mrqchip/TermWylPompy/Dokument/ZdjeciaOkolicPompy/IMG_20190823_191804.jpg

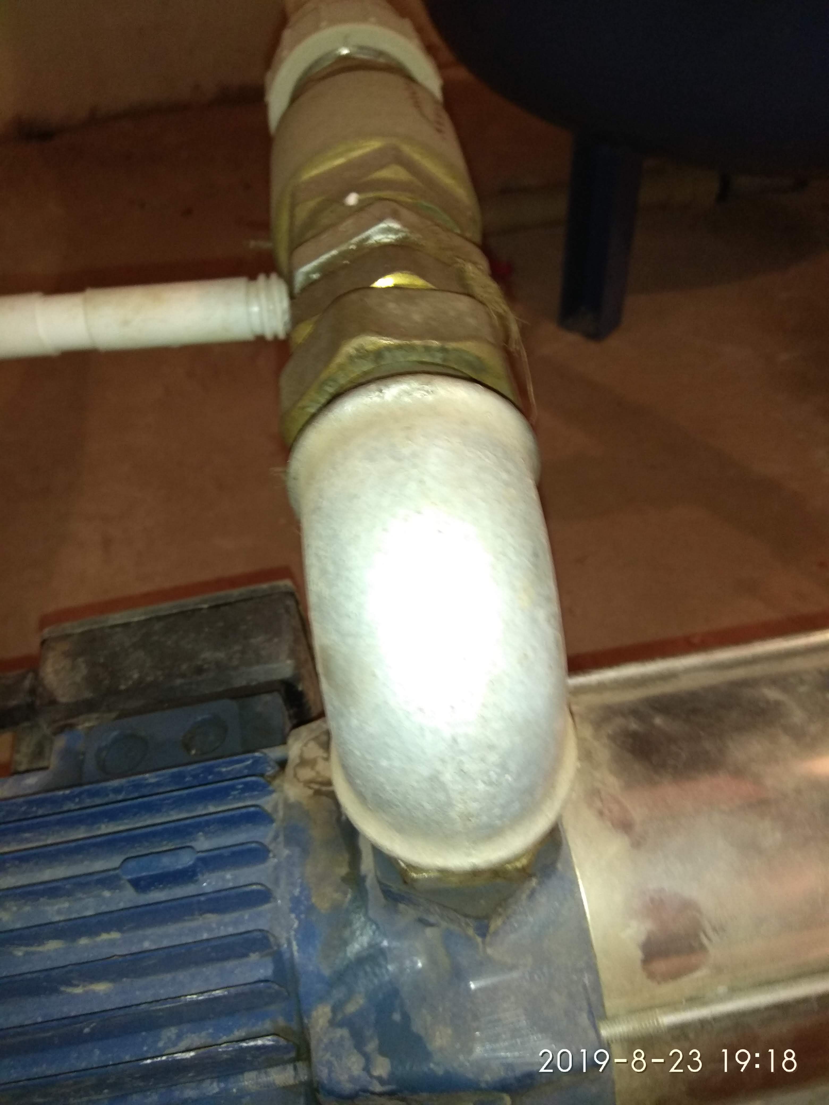
Dokument/ZdjeciaOkolicPompy/IMG_20190823_191804.jpg
