mrqchip/TermWylPompy/TermWylPompy/tflex/TermWylPompyBase.png

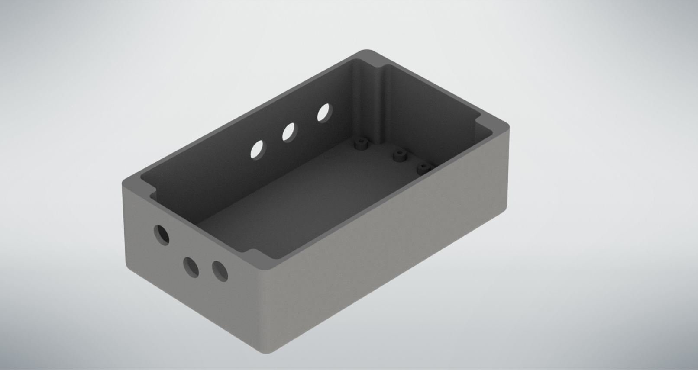
TermWylPompy/tflex/TermWylPompyBase.png
