mrqchip/TermWylPompy/README.md

# TermWylPompy
## Wyłącznik pompy ogrodowej, chroniący ją przed długotrwałym suchobiegiem.

Suchobieg pompy jest wykrywany przez pomiar temperatury korpusu pompy i nadmiernie długi czas włączenia (np. 2 godziny lub 30 stopni ponad temperaturę otoczenia, co pierwsze wystąpi). Badana jest temperatura silnika, temperatura rury na wyjściu z pompy i temperatura otoczenia.
Po stwierdzeniu suchobiegu pompa jest trwale wyłączana i wymaga interwencji personelu, 
który powinien stwierdzić przyczynę braku wody w  instalacji.
Kasowanie stanu suchobiegu włącza pompę na zadany czas. Jeśli w tym czasie nie nastapi obniżenie temperatury poniżej zadanej,
wyłącznik wprowadzi się znowu w stan suchobiegu.
Sterownik co ustalony czas (np. 192 godziny) od ostatniego włączenia pompy otwiera elektrozawór opróżniający instalację. To wymusza włączenie pompy i po jej włączeniu elektrozawór jest zamykany.
