mrqchip/TermWylPompy/Dokument/ZdjeciaOkolicPompy/IMG_20190823_191732.jpg

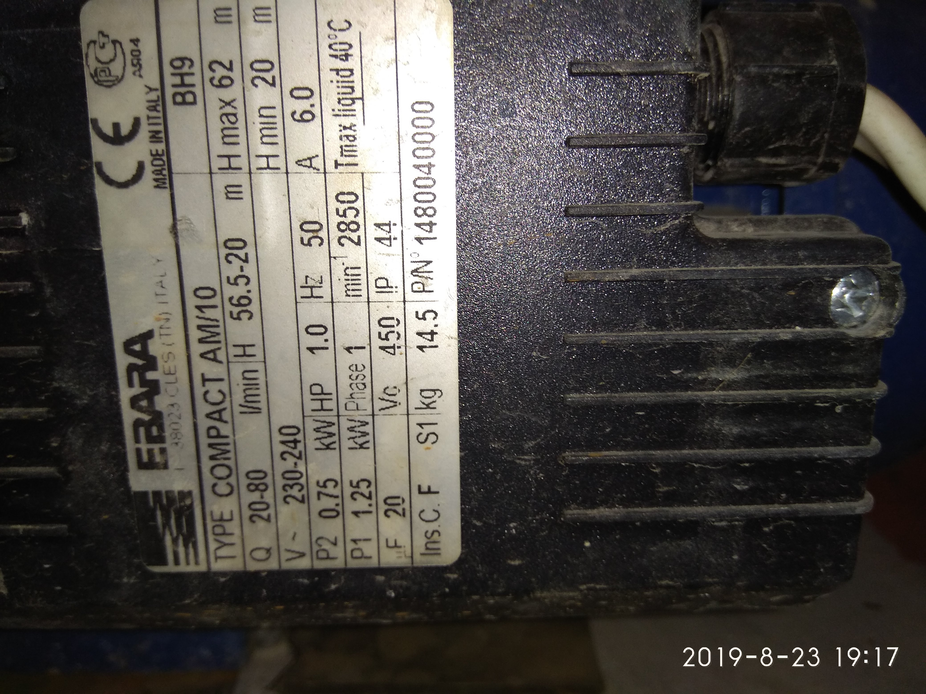
Dokument/ZdjeciaOkolicPompy/IMG_20190823_191732.jpg
