mrqchip/TermWylPompy/Dokument/ZdjeciaOkolicPompy/IMG_20190823_191752.jpg

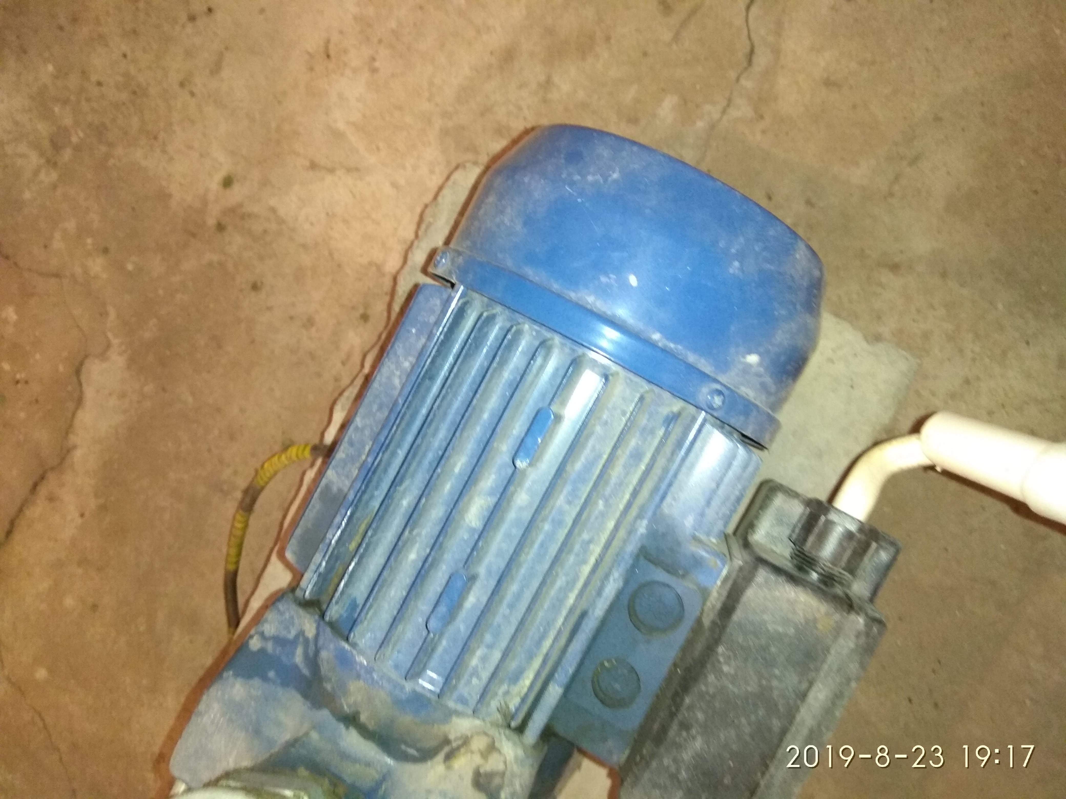
Dokument/ZdjeciaOkolicPompy/IMG_20190823_191752.jpg
