mrqchip/TermWylPompy/Dokument/ZdjeciaOkolicPompy/IMG_20190823_191833.jpg

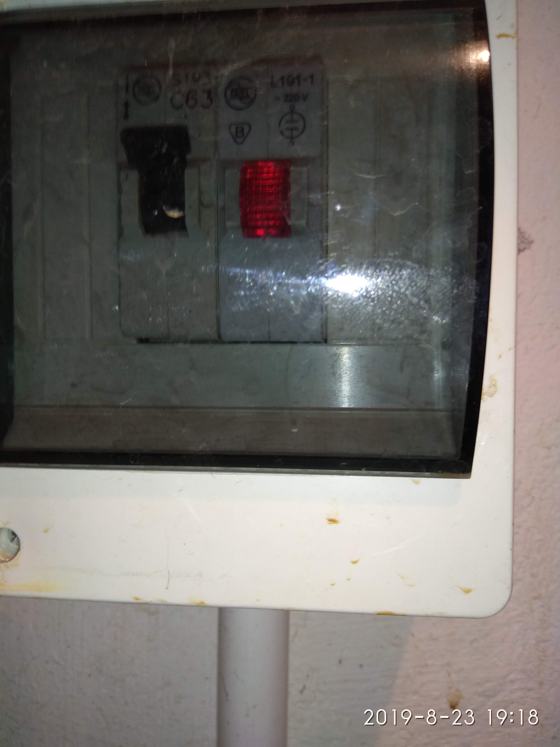
Dokument/ZdjeciaOkolicPompy/IMG_20190823_191833.jpg
