mrqchip/TermWylPompy/Dokument/ZdjeciaOkolicPompy/IMG_20190823_191855.jpg

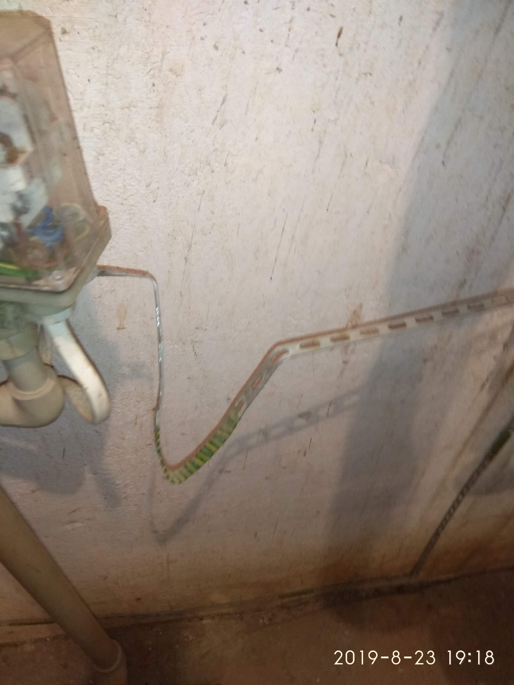
Dokument/ZdjeciaOkolicPompy/IMG_20190823_191855.jpg
