mrqchip/TermWylPompy/TermWylPompy/tflex/TermWylPompy.png

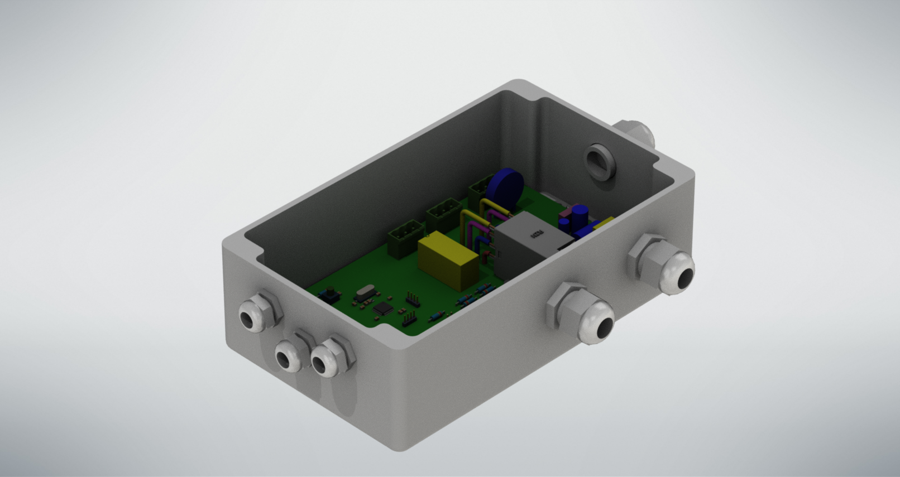
TermWylPompy/tflex/TermWylPompy.png
