mrqchip/TermWylPompy/TermWylPompy/tflex/TermWylPompyLid.png

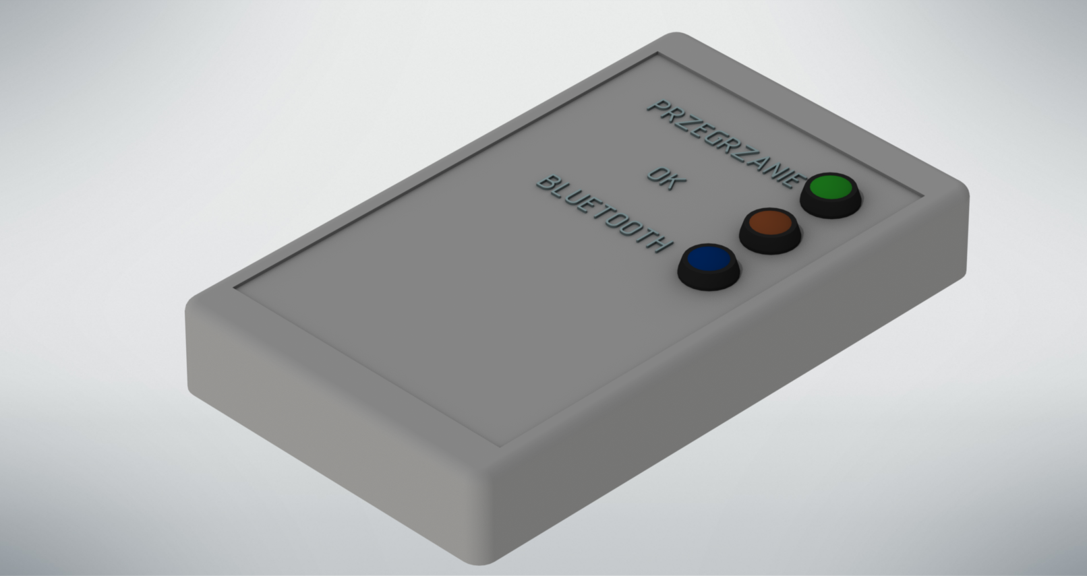
TermWylPompy/tflex/TermWylPompyLid.png
