mrqchip/TermWylPompy/TermWylPompy/tflex/V12B-10G-A.png

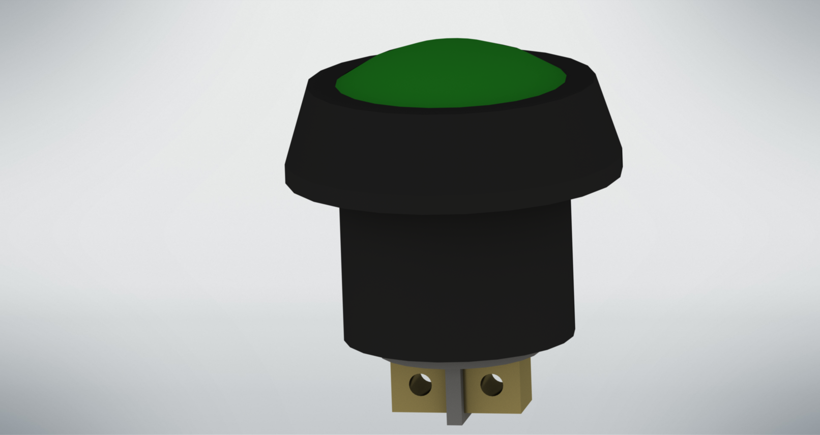
TermWylPompy/tflex/V12B-10G-A.png
