mrqchip/TermWylPompy/TermWylPompy/sch/v1/BOM/BOM-TermWylPompy1.xls

Designator | Value | #Column Name Error:' OtherParams | Descript | Supplier5 | Reference5 | Stock | Typ5 | DateOfPrice5 | Price5 | Quantity | Footprint | Kod
+4V1 | LED0603-RW120 |  | Dioda LED, SMD 0603, Czerwona 626-636nm, 50-70 mCd /10mA, water clear, 120° | maritex.com.pl | LED0603-RW120 |  | LED0603-RW120 | 10-05-2020 | 0,12 | 1 | D0603 | Opt25
230VAC, PRESSSW, PUMP | DG300-7.5-3P11 |  | Listwa zaciskowa; kątowe 90°; 2,5mm2; 7,5mm; tory:3; cynowany; 24A | tme.pl | DG300-7.5-3P11 |  | DG300-7.5-03P-11-00A(H) | 01-01-2010 | 1 | 3 | DG300-7.5-3P11 | Con33
C1c, C2c, C2s, C3c, C8c, C9s, C10c, C11c, C12c, C13c, C14c | 100n/50 |  | Kondensator: ceramiczny; MLCC; 100nF; 50V; X7R; ±10%; SMD; 0805 | tme.pl | CL21B104KBCNNNC |  | CL21B104KBCNNNC | 01-01-2010 | 0 | 11 | 0805 | CAP7
C1r | 10u/10 |  | Kondensator: ceramiczny; MLCC; 10uF; 10V; X7R; ±10%; SMD; 0805 | tme.pl | CL21B106KPQNNNG |  | CL21B106KPQNNNG | 01-01-2010 | 0 | 1 | 0805 | CAP25
C1s | 470u/25 |  | capacitor electrolythic 470uF/25V, 20%, 10x16, 5mm, low ESR | tme.pl | GT470/25 |  | GT470u/25 | 01-01-2010 | 0 | 1 | CE2040 | CAP81
C2r, C6c, C7s, C8s | 1u/25 |  | Kondensator: ceramiczny; MLCC; 1uF; 25V; X7R; ±10%; SMD; 0805 | tme.pl | CL21B105KAFNNN |  | CL21B105KAFNNN | 01-01-2010 | 0 | 4 | 0805 | CAP38
C3s | 100u/35 |  | Kondensator: elektrolityczny; THT; 100uF; 35VDC; Ø6,3x11mm; ±20% | tme.pl | SD1V107M6L011BB |  | SD1V107M6L011BB | 01-01-2010 | 0 | 1 | CE1028 | CAP15
C4c | 4u7/16 |  | Kondensator: ceramiczny; MLCC; 4,7uF; 16VDC; X7R; ±5%; SMD; 0805 | tme.pl | C0805C475J4RACAUTO |  | C0805C475J4RACAUTO | 10-05-2020 | 1,5 | 1 | 0805 | CAP97
C4s | 4u7/50 |  | Kondensator: ceramiczny; 4,7uF; 50V; X7R; ±10%; SMD; 1210; -55÷125°C | tme.pl | CL32B475KBUYNNE |  | CL32B475KBUYNNE | 01-01-2010 | 2 | 1 | 1210 | CAP99
C5c | 10n/50 |  | Kondensator: ceramiczny; MLCC; 10nF; 50V; X7R; ±10%; SMD; 0805 | tme.pl | CL21B103KBANNNC |  | CL21B103KBANNNC | 01-01-2010 | 0 | 1 | 0805 | CAP21
C5s | 220p/50 |  | Kondensator: ceramiczny; 220pF; 50V; X7R; ±10%; SMD; 0603; -55÷125°C | tme.pl | CL10B221KB8NNNC |  | CL10B221KB8NNNC | 01-01-2010 | 0 | 1 | 0603-IPC | CAP45
C6s | 22n/50 |  | Kondensator: ceramiczny; 22nF; 50V; X7R; ±10%; SMD; 0603; -55÷125°C | tme.pl | CL10B223KB8NNNC |  | CL10B223KB8NNNC | 01-01-2010 | 0 | 1 | 0603-IPC | CAP51
C7c, C9c | 22p/50 |  | Kondensator: ceramiczny; MLCC; 22pF; 50V; C0G; ±5%; SMD; 0805 | tme.pl | CL21C220JBANNNC |  | CL21C220JBANNNC | 10-05-2020 | 0,12 | 2 | 0805 | CAP54
D1d, D2d, D3d | RCLAMP0504S.TCT |  | Dioda: drabinka diodowa; 6V; 6A; jednokierunkowa; 150W; SOT23-6 | tme.pl | RCLAMP0504S.TCT |  | RCLAMP0504S.TCT | 01-01-2010 | 1 | 3 | SOT23-6 | DIO7
D1r | LED3-R-LC |  | LED; 3mm; czerwony; 30mcd; 30°; Czoło: wypukłe; Raster: 2,54mm | tme.pl | OSNR3134A |  | OSNR3134A | 01-01-2010 | 0 | 1 | CO26 | Opt44
D1s | 10MQ040N |  | Dioda: prostownicza Schottky; SMD; 40V; 2,1A; DO214AC | tme.pl | 10MQ040NTRPBF |  | VS-10MQ040NTRPBF | 01-01-2010 | 0 | 1 | SMA | DIO1
D2s | BZX84C5V1 |  | Zener diode 5.1V, 0.3W, SOT-23 | tme.pl | BZX84C5V1 |  | BZX84-C5V1.215 | 01-01-2010 | 0 | 1 | SOT23-3 | DIO13
Dbg | ZL303-04P |  | Listwa kołkowa; kołkowe; męskie; PIN:4; proste; 2mm; THT; 1x4 | tme.pl | ZL303-04P |  | ZL303-04P | 10-05-2020 | 0,2 | 1 | PLMS4S | Con298
F1s | 1FM414-1R |  | Radio filter 250VAC, 1A | tme.pl | 1FM414-1R |  |  | 01-01-2010 | 15 | 1 | 1FM414 | Ind14
J1c | NS25-W4P |  | Gniazdo; przewód-płytka; męskie; PIN:4; 2,54mm; THT; NS25; 250V; 3A | tme.pl | NS25-W4P |  | NS25-W4P | 01-01-2010 | 0 | 1 | WF04S | Con107
J1r | JUMPERx3 |  | Listwa kołkowa; kołkowe; męskie; PIN: 3; proste; 2,54mm; THT; 1x3 | tme | ZL201-03G |  |  | 01-01-2010 | 0 | 1 | 3SIP100 | Con59
J2c | NS25-W5P |  | Gniazdo; przewód-płytka; męskie; PIN:5; 2,54mm; THT; NS25; 250V; 3A | tme.pl | NS25-W5P |  | NS25-W5P | 01-01-2010 | 0 | 1 | WF05S | Con109
J2r, J3r, J4r | ZL201-02G |  | Listwa kołkowa; kołkowe; męskie; PIN:2; proste; 2,54mm; THT; 1x2 | tme.pl | ZL201-02G |  |  | 01-01-2010 | 0 | 3 | PLS2S | Con279
L1c | BLM21AG121SN1D |  | Chip inductor SMD, 0805, Imax=0.2A,Z=120ohm, Rdc=0.15ohm | tme.pl | BLM21AG121SN1D |  |  | 01-01-2010 | 0 | 1 | 0805 | Ind42
L1s | 68u/3.2A |  | 7447709680 - Cewka mocy do montażu powierzchniowego, Seria WE-PD, 68 µH, 3.2 A, 3.6 A, Osłonięte, 0.089 ohm | farnell.com | 1635947 |  | 7447709680 | 01-01-2010 | 10 | 1 | SRR1208 | Ind37
M1r | RN4678-V/RM100 |  | Moduł: Bluetooth Classic / Low Energy; GPIO,SPI,UART; SMD | tme | RN4678-V/RM100 |  | RN4678-V/RM100 | 01-01-2010 | 38 | 1 | RN4678 | Mod96
M1s | MFM-10-24 |  | Zasilacz: impulsowy; 10W; 80÷264VAC; Wyjścia: 1; 420mA; -30÷85°C | tme.pl | MFM-10-24 |  | MFM-10-24 | 2010-01-01 | 33 | 1 | MFM-10-24 | Mod92
Mon | DF09PP |  | Gniazdo; D-Sub; PIN:9; żeńskie; proste; THT; złocony | tme.pl | DF09PP |  | DS1034-09FUNSISS | 01-01-2010 | 1 | 1 | DB9/F | Con312
PK1s | R2N-2012-23-1024-WTLD |  | Przekaźnik: elektromagnetyczny; DPDT; Ucewki : 24VDC; 12A/250VAC | tme | R2N2012231024WTLD |  | R2N-2012-23-1024-WTLD | 01-01-2010 | 28 | 1 | R2N-WTLD-H | Rel21
R1c, R2c, R3c, R4c, R5s, R6c, R8c, R8s, R11s | 10k |  | Rezystor: metal film; THT; 10kΩ; 0,6W; ±1%; Ø2,5x6,8mm; 50ppm/°C | tme.pl | M0.6W-10K |  | MF006FF1002A50 | 25-06-2020 12:16:54 | 0,1 | 9 | R402510 | Res17
R1d, R2d, R5d, R6d, R9d, R10d | 4k7 |  | Rezystor: thick film; SMD; 0805; 4,7kΩ; 0,125W; ±1%; -55÷125°C | tme.pl | SMD0805-4K7-1% |  | 0805S8F4701T5E | 25-06-2020 12:16:54 | 0,1 | 6 | 0805R | Res172
R1r | 100R |  | Rezystor: metal film; THT; 100Ω; 0,6W; ±1%; Ø2,5x6,8mm; 50ppm/°C | tme.pl | M0.6W-100R |  | MF006FF1000A50 | 25-06-2020 12:16:54 | 0,1 | 1 | R402510 | Res343
R1s | 5k1 |  | Rezystor: thick film; SMD; 0805; 5,1kΩ; 0,125W; ±1%; -55÷125°C | tme.pl | SMD0805-5K1-1% |  | 0805S8F5101T5E | 25-06-2020 12:16:54 | 0,1 | 1 | 0805R | Res198
R2r | 10k |  | Rezystor: metal film; THT; 10kΩ; 0,6W; ±1%; Ø2,5x6,8mm; 50ppm/°C | tme.pl | M0.6W-10K |  | MF006FF1002A50 | 25-06-2020 12:16:54 | 0,1 | 1 | R402510V | Res17
R2s | 2k2 |  | Rezystor: thick film; SMD; 0805; 2,2kom; 0,125W; ±1%; -55÷125°C | tme.pl | SMD0805-2K2-1% |  | 0805WAF 2K2 T5E | 25-06-2020 12:16:54 | 0,1 | 1 | 0805R | Res110
R3d, R4d, R7d, R8d, R11d, R12d | 100R |  | Rezystor: thick film; SMD; 0805; 100om; 0,125W; ±1%; -55÷125°C | tme.pl | SMD0805-100R-1% |  | 0805S8F1000T5E | 25-06-2020 12:16:54 | 0,1 | 6 | 0805R | Res13
R3s | 4k7 |  | Rezystor: thick film; SMD; 0603; 4,7kom; 0,1W; ±1%; -55÷125°C | tme.pl | SMD0603-4K7-1% |  | 0603SAF4701T5E | 25-06-2020 12:16:54 | 0,1 | 1 | 0603R | Res171
R4s | 1k |  | Rezystor: thick film; SMD; 0805; 1kom; 0,125W; ±1%; -55÷125°C | tme.pl | SMD0805-1K-1% |  | 0805WAF 1K T5E | 25-06-2020 12:16:54 | 0,1 | 1 | 0805R | Res53
R5c | 220R |  | Rezystor: thick film; SMD; 0805; 220Ω; 0,125W; ±1%; -55÷125°C | tme.pl | SMD0805-220R-1% |  | 0805S8F2200T5E | 10-05-2020 | 0,08 | 1 | 0805R | Res88
R6s, R7s, R9s, R10s | 1k |  | Rezystor: metal film; THT; 1kom; 0,6W; ±1%; Ø2,5x6,8mm; 50ppm/°C | tme.pl | M0.6W-1K |  | MF006FF1001A50 | 25-06-2020 12:16:54 | 0,1 | 4 | R402510 | Res344
R7c | 100k |  | Rezystor: metal film; THT; 100kohm; 0,6W; ±1%; Ø2,5x6,8mm; 50ppm/°C | tme.pl | M0.6W-100K |  | MF006FF1003A50 | 25-06-2020 12:16:54 | 0,1 | 1 | R402510 | Res11
R12s, R13s | 120R |  | Rezystor: metal film; THT; 120Ω; 0,6W; ±1%; Ø2,5x6,8mm; 50ppm/°C | tme.pl | M0.6W-120R |  | MF006FF1200A50 | 25-06-2020 12:16:54 | 0,1 | 2 | R402510 | Res306
RE1s | RM84-2012-35-5230 |  | Przekaźnik: elektromagnetyczny; DPDT; Ucewki: 230VAC; 8A/250VAC | tme.pl | RM84-P-230VAC |  | RM84-2012-35-5230 | 01-01-2010 | 15 | 1 | RM84-P | Rel15
RESET | DTS63K |  | Mikroprzełącznik TACT; SPST-NO; Pozycje: 2; 0,05A/12VDC; THT; brak | tme.pl | DTS63K |  | DTS-63K | 01-01-2010 | 1 | 1 | DTS63K | Elm16
T1c, T1s, T2c, T2s, T3c | BC547 |  | Tranzystor: NPN; bipolarny; 50V; 100mA; 500mW; TO92 | tme.pl | BC547A |  | BC547A | 01-01-2010 | 0,1 | 5 | CE35V4 | Tra9
T1d, T2d, T3d, T4d, T5d, T6d | 2N7002 |  | Tranzystor: N-MOSFET; unipolarny; 60V; 800mA; 200mW; SOT23 | tme.pl | 2N7002 |  | 2N7002 | 01-01-2010 | 0 | 6 | SOT23-3 | Tra2
TH1, TH2, TH3 | Wago233-204 |  | PCB terminal strip with push buttons 0.5mm2 | soselectronic.pl | 112495 |  | 233-204 | 01-01-2010 | 5 | 3 | Wago233-204 | Con261
U1c | STM32F103CBT6 |  | ARM Cortex-M3 CPU, 128kB Flash, 20kB RAM, USB, CAN, 3xUART, 2xI2C, 2xSPI, ADC, STM, LQFP48, RoHS | kamami.pl | 42865 |  | STM32F103CBT6 | 10-05-2020 | 13 | 1 | MS-026ABC | ICs272
U1s | L5973D |  | Driver; przetwornica DC/DC; 2,5A; 1,2÷35V; 2,25W; Kanały: 1; 250kHz | tme.pl | L5973D |  | L5973D | 01-01-2010 | 10 | 1 | HSOP8 | ICs119
U2c | ST3232CD |  | DUAL EIA-232 DRIVER/RECEIVER, 3-5V | tme.pl | ST3232CD |  | ST3232CD | 01-01-2010 | 2 | 1 | 16SOIC150 | ICs256
U2s | MCP1700T3302ETT |  | Stabilizator napięcia; LDO, nieregulowany; 3,3V; 0,25A; SOT23-3 | tme.pl | MCP1700T3302ETT |  | MCP1700T3302E/TT | 10-05-2020 | 1,8 | 1 | SOT23-3 | ICs182
VR1s | SIOV-S20K250 |  | Warystor: metalowo-tlenkowy; THT; 250VAC; 320VDC; 390V; 8000A; 140J | tme.pl | SIOV-S20K250 |  | S20K250 | 03-06-2020 | 2,6 | 1 | SIOV-S20K275 | Vre35
X1c | 8.00MHz |  | Rezonator: kwarcowy; 8MHz; ±30ppm; 20pF; SMD; HC49SM | tme.pl | 8.00M-SMDHC49S |  |  | 10-05-2020 | 2 | 1 | HC49SMP | Qua16
