mrqchip/TermWylPompy/TermWylPompy/tflex/TermWylPompy.pdf

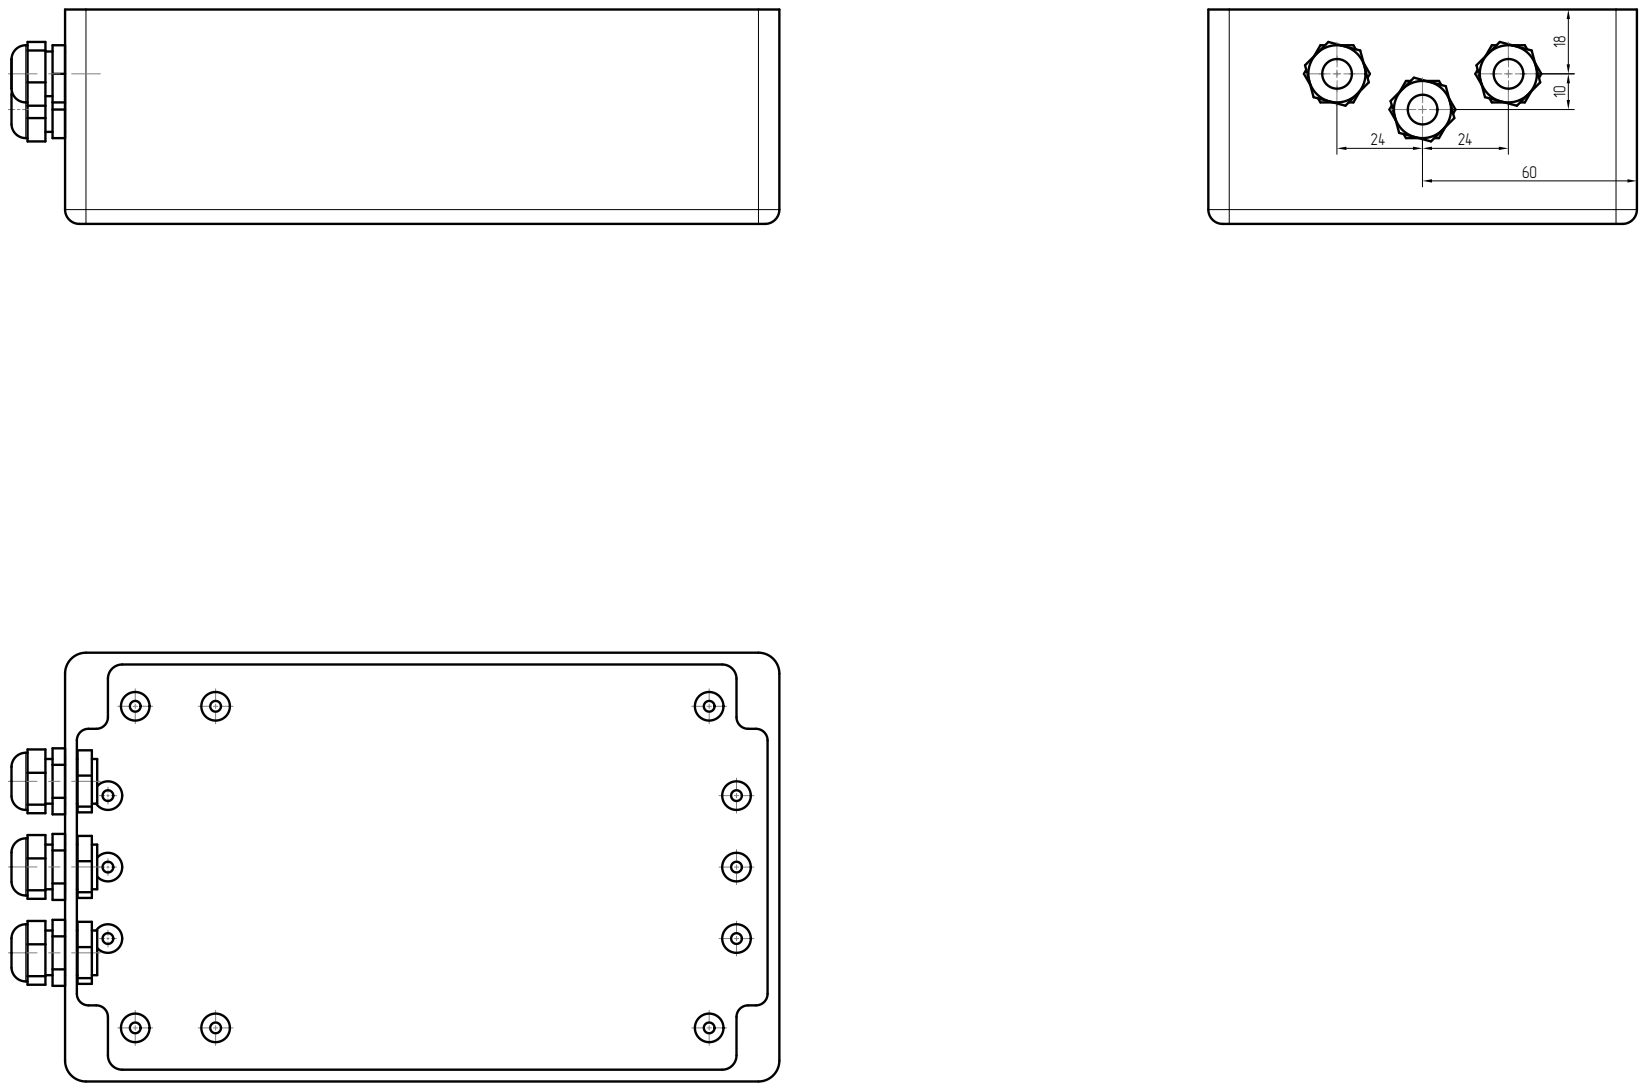
[picture p10: page 1]

3d
