mrqchip/TermWylPompy/(list of files, drawings)

Other design files:
Dokument/ATNEL/ATNEL-WIFI232-T/ATNEL-WIFI232-T.PcbLib
Dokument/ATNEL/ATNEL-WIFI232-T/ATNEL-WIFI232-T.SchLib
Skrzynka1/sch/Skrzynka1.PrjPcb
Skrzynka1/sch/Skrzynka1_main.SchDoc
TermWylPompy/sch/v1/TermWylPomp1_cpu.SchDoc
TermWylPompy/sch/v1/TermWylPomp1_ds18.SchDoc
TermWylPompy/sch/v1/TermWylPomp1_rf.SchDoc
TermWylPompy/sch/v1/TermWylPomp1_supp.SchDoc
TermWylPompy/sch/v1/TermWylPompy1.PcbDoc
TermWylPompy/sch/v1/TermWylPompy1.PrjPcb
TermWylPompy/sch/v1/TermWylPompy1_main.SchDoc
