mrqchip/TermWylPompy/(threads)

Thread 5 (2019-08-20):

Określenie liczby i funkcji przycisków oraz diod LED

mrqchip, 2019-08-20:
## Przyciski

Nazwa wewnętrzna na płytce drukowanej|Nazwa na obudowie|Funkcja
--|--|--
Key0|Wł/Kasuj|Ręcznie włącza zasilanie pompy
Key1|Wył|Ręcznie wyłącza pompę
Key2|Konfig|włącza Bluetooth i czeka na sparowanie z telefonem, ponowne naciśnięcie kończy połączenie

## Diody LED
Nazwa wewnętrzna na płytce drukowanej|Nazwa na obudowie|Kolor diody|Funkcja
--|--|--|--
LEDR|Przegrzanie/Wył|czerwona|Migocze z częstotliwością 0,5Hz, gdy nastąpiło przegrzanie, nie świeci podczas poprawnej pracy pompy, gaśnie po naciśnięciu przycisku "Wł/Kasuj" (Key0), świeci ciągle po ręcznym wyłączeniu pompy za pomocą przycisku "Wył" (KEY1)
LEDG|Ok|zielona|Poprawna praca pompy. Świeci ciągle podczas poprawnej pracy pompy, gaśnie po wyłączeniu pompy
LEDB|Bluetooth|niebieska|Migocze z częstotliwością 3/4Hz podczas oczekiwania na sparowanie, świeci ciągle po nawiązaniu połączenia z telefonem, gaśnie po zakończeniu połączenia Bluetooth

Thread 13 (2020-08-10):

Maksymalne wymiary płytki

mrqchip, 2020-08-10:
Określić maksymalne wymiary płytki drukowanej na podstawie pomiarów płyty

mrqchip, 2020-08-11:
Wymiar poziomy 230mm.

mrqchip, 2020-08-11:
Wymiar poziomy 115mm.
