mrqchip/TermWylPompy/(commit log)

2019-08-18 19-08-18 1915
    [TermWylPomp1_cpu.SchDoc, TermWylPomp1_ds18.SchDoc, TermWylPomp1_supp.SchDoc, TermWylPompy1.PrjPcb, TermWylPompy1_main.SchDoc]
2019-08-19 19-08-19 2124
    [TermWylPomp1_supp.SchDoc]
2019-08-20 19-08-20 2042
    [TermWylPomp1_cpu.SchDoc]
2019-08-21 19-08-21 2052
    [TermWylPomp1_cpu.SchDoc, TermWylPomp1_ds18.SchDoc, TermWylPompy1_main.SchDoc]
2019-08-22 19-08-22 2108
    [TermWylPomp1_cpu.SchDoc, TermWylPomp1_supp.SchDoc, TermWylPompy1.PrjPcb, TermWylPompy1_main.SchDoc]
2019-08-23 19-08-23 2103
    [TermWylPomp1_rf.SchDoc]
2019-08-25 19-08-25 1842
    [TermWylPomp1_supp.SchDoc]
2019-08-26 19-08-26 0825
    [TermWylPomp1_supp.SchDoc]
2019-08-26 19-08-26 2053
    [TermWylPomp1_supp.SchDoc]
2019-09-02 19-09-02 2036
    [TermWylPomp1_cpu.SchDoc, TermWylPomp1_rf.SchDoc, TermWylPomp1_supp.SchDoc, TermWylPompy1_main.SchDoc]
2019-11-01 19-11-01 2203
    [TermWylPomp1_rf.SchDoc, TermWylPompy1.PrjPcb]
2019-11-03 19-11-03 1958
    [TermWylPomp1_cpu.SchDoc, TermWylPomp1_ds18.SchDoc, TermWylPomp1_rf.SchDoc, TermWylPomp1_supp.SchDoc, TermWylPompy1.PrjPcb, TermWylPompy1_main.SchDoc]
2019-11-06 19-11-06 2114
    [TermWylPompy1.PcbDoc, TermWylPompy1.PrjPcb]
2019-11-16 19-11-16 1954
    [TermWylPomp1_cpu.SchDoc, TermWylPomp1_ds18.SchDoc, TermWylPomp1_supp.SchDoc, TermWylPompy1_main.SchDoc]
2019-12-03 19-12-03 2046
    [TermWylPomp1_cpu.SchDoc, TermWylPomp1_ds18.SchDoc, TermWylPomp1_rf.SchDoc, TermWylPomp1_supp.SchDoc, TermWylPompy1.PcbDoc, TermWylPompy1.PrjPcb, TermWylPompy1_main.SchDoc]
2019-12-06 19-12-06 1823
    [TermWylPomp1_cpu.SchDoc, TermWylPomp1_ds18.SchDoc, TermWylPomp1_supp.SchDoc, TermWylPompy1.PcbDoc, TermWylPompy1.PrjPcb]
2019-12-08 19-12-08 1804
    [TermWylPomp1_cpu.SchDoc, TermWylPomp1_ds18.SchDoc, TermWylPomp1_rf.SchDoc, TermWylPomp1_supp.SchDoc, TermWylPompy1.PcbDoc, TermWylPompy1.PrjPcb, TermWylPompy1_main.SchDoc]
2019-12-22 19-12-22 2047
    [TermWylPomp1_cpu.SchDoc, TermWylPomp1_rf.SchDoc, TermWylPompy1.PcbDoc, TermWylPompy1_main.SchDoc]
2020-01-02 20-01-02 2122
    [TermWylPompy1.PcbDoc]
2020-01-04 20-01-04 2030
    [TermWylPompy1.PcbDoc, TermWylPompy1.PrjPcb]
2020-01-08 20-01-08 2044
    [TermWylPomp1_cpu.SchDoc, TermWylPompy1.PcbDoc, TermWylPompy1_main.SchDoc]
2020-01-09 20-01-09 2100
    [TermWylPomp1_cpu.SchDoc, TermWylPomp1_rf.SchDoc, TermWylPomp1_supp.SchDoc, TermWylPompy1.PcbDoc, TermWylPompy1_main.SchDoc]
2020-01-12 20-01-12 2041
    [TermWylPomp1_cpu.SchDoc]
2020-01-14 20-01-14 2104
    [TermWylPomp1_cpu.SchDoc, TermWylPompy1.PcbDoc]
2020-01-28 20-01-28 2104
    [TermWylPomp1_cpu.SchDoc, TermWylPomp1_ds18.SchDoc, TermWylPomp1_rf.SchDoc, TermWylPompy1.PcbDoc]
2020-01-29 20-01-29 2115
    [TermWylPomp1_cpu.SchDoc, TermWylPomp1_rf.SchDoc, TermWylPomp1_supp.SchDoc, TermWylPompy1.PcbDoc]
2020-01-30 20-01-30 2156
    [TermWylPompy1.PcbDoc]
2020-02-02 20-02-02 1128
    [TermWylPomp1_cpu.SchDoc, TermWylPomp1_ds18.SchDoc, TermWylPomp1_rf.SchDoc, TermWylPomp1_supp.SchDoc, TermWylPompy1.PcbDoc, TermWylPompy1.PrjPcb]
2020-02-04 20-02-04 2057
    [TermWylPomp1_supp.SchDoc, TermWylPompy1.PcbDoc]
2020-02-05 20-02-05 2101
    [TermWylPompy1.PcbDoc]
2020-06-07 20-06-07 2005
    [TermWylPomp1_cpu.SchDoc, TermWylPomp1_supp.SchDoc, TermWylPompy1.PrjPcb, TermWylPompy1_main.SchDoc]
2020-06-30 20-06-30 1839
    [TermWylPompy1.PrjPcb]
2020-07-05 20-07-05 2107
    [TermWylPomp1_supp.SchDoc]
2020-07-07 20-07-07 1850
    [ATNEL-WIFI232-T.PcbLib, ATNEL-WIFI232-T.SchLib]
2020-07-11 20-07-11 2059
    [Skrzynka1.PrjPcb, Skrzynka1_main.SchDoc, TermWylPomp1_supp.SchDoc]
2020-07-16 20-07-16 2102
    [TermWylPomp1_supp.SchDoc]
2020-07-17 20-07-17 0916
    [BOM-TermWylPompy1.xls, TermWylPomp1_cpu.SchDoc, TermWylPomp1_ds18.SchDoc, TermWylPomp1_rf.SchDoc, TermWylPomp1_supp.SchDoc, TermWylPompy1.PcbDoc, TermWylPompy1.PrjPcb]
2020-07-17 20-07-17 1820
    [BOM-TermWylPompy1.xls, TermWylPomp1_cpu.SchDoc, TermWylPomp1_ds18.SchDoc, TermWylPomp1_rf.SchDoc, TermWylPomp1_supp.SchDoc, TermWylPompy1.PcbDoc]
2020-07-20 20-07-20 1905
    [TermWylPomp1_cpu.SchDoc, TermWylPomp1_ds18.SchDoc, TermWylPomp1_rf.SchDoc, TermWylPompy1_main.SchDoc]
2020-07-21 20-07-21 1930
    [TermWylPomp1_cpu.SchDoc]
2020-07-22 20-07-22 1913
    [TermWylPomp1_cpu.SchDoc, TermWylPomp1_supp.SchDoc, TermWylPompy1_main.SchDoc]
2020-07-24 20-07-24 1545
    [TermWylPomp1_cpu.SchDoc]
2020-07-24 20-07-24 2017
    [TermWylPomp1_cpu.SchDoc, TermWylPomp1_ds18.SchDoc, TermWylPomp1_rf.SchDoc, TermWylPomp1_supp.SchDoc, TermWylPompy1.PrjPcb, TermWylPompy1_main.SchDoc]
2020-07-26 20-07-26 2012
    [TermWylPomp1_cpu.SchDoc, TermWylPomp1_rf.SchDoc, TermWylPomp1_supp.SchDoc, TermWylPompy1.PcbDoc, TermWylPompy1_main.SchDoc]
2020-07-27 20-07-27 1912
    [TermWylPomp1_cpu.SchDoc, TermWylPompy1.PcbDoc, TermWylPompy1.PrjPcb]
2020-07-29 20-07-29 1946
    [TermWylPomp1_cpu.SchDoc, TermWylPompy1.PcbDoc]
2020-07-31 20-07-31 2044
    [TermWylPomp1_cpu.SchDoc, TermWylPompy1.PcbDoc]
2020-08-01 20-08-01 1940
    [TermWylPomp1_cpu.SchDoc, TermWylPomp1_ds18.SchDoc, TermWylPomp1_rf.SchDoc, TermWylPomp1_supp.SchDoc, TermWylPompy1.PcbDoc, TermWylPompy1_main.SchDoc]
2020-08-03 20-08-03 1850
    [TermWylPomp1_cpu.SchDoc, TermWylPomp1_rf.SchDoc, TermWylPomp1_supp.SchDoc, TermWylPompy1.PcbDoc, TermWylPompy1_main.SchDoc]
2020-08-05 20-08-05 1955
    [TermWylPomp1_cpu.SchDoc, TermWylPomp1_supp.SchDoc, TermWylPompy1.PcbDoc]
2020-08-11 20-08-11 2230
    [TermWylPomp1_cpu.SchDoc, TermWylPomp1_rf.SchDoc, TermWylPomp1_supp.SchDoc, TermWylPompy1.PcbDoc]
2020-08-12 20-08-12 1855
    [TermWylPompy1.PcbDoc]
2020-08-13 20-08-13 0910
    [TermWylPompy1.PcbDoc]
2020-08-13 20-08-13 1828
    [TermWylPompy1.PcbDoc]
